13hihi31/tt09-analog-tdc/mag/input_stage_andpwr.sim.spice

* NGSPICE file created from input_stage_andpwr_parax.ext - technology: sky130A

.subckt input_stage_andpwr_parax in en t0 t1 t2 t3 and_pwr VDD VSS out
X0 a_2134_616# t0.t0 a_1870_1170# VSS.t10 sky130_fd_pr__nfet_01v8 ad=0.29 pd=2.29 as=0.58 ps=4.58 w=2 l=0.15
X1 a_3160_1170# fine_delay_unit_1.in VDD.t7 VDD.t6 sky130_fd_pr__pfet_01v8 ad=0.87 pd=6.58 as=0.87 ps=6.58 w=3 l=0.15
X2 a_3248_1170# fine_delay_unit_1.in a_3160_1170# VSS.t20 sky130_fd_pr__nfet_01v8 ad=0.145 pd=1.29 as=0.145 ps=1.29 w=1 l=0.15
X3 VSS.t13 t3.t0 a_3512_616# VSS.t12 sky130_fd_pr__nfet_01v8 ad=0.58 pd=4.58 as=0.29 ps=2.29 w=2 l=0.15
X4 VSS.t11 fine_delay_unit_0.in a_2134_616# VSS.t0 sky130_fd_pr__nfet_01v8 ad=0.145 pd=1.29 as=0.145 ps=1.29 w=1 l=0.15
X5 nand_gate_0.out in.t0 and_pwr.t3 and_pwr.t2 sky130_fd_pr__pfet_01v8 ad=0.435 pd=3.29 as=0.87 ps=6.58 w=3 l=0.15
X6 VSS.t19 fine_delay_unit_1.in a_3512_616# VSS.t12 sky130_fd_pr__nfet_01v8 ad=0.145 pd=1.29 as=0.145 ps=1.29 w=1 l=0.15
X7 a_306_476# in.t1 VSS.t22 VSS.t21 sky130_fd_pr__nfet_01v8 ad=0.29 pd=2.29 as=0.58 ps=4.58 w=2 l=0.15
X8 fine_delay_unit_0.in nand_gate_0.out and_pwr.t1 and_pwr.t0 sky130_fd_pr__pfet_01v8 ad=0.87 pd=6.58 as=0.87 ps=6.58 w=3 l=0.15
X9 a_3160_1170# fine_delay_unit_1.in a_3248_1170# VSS.t18 sky130_fd_pr__nfet_01v8 ad=0.145 pd=1.29 as=0.145 ps=1.29 w=1 l=0.15
X10 a_2134_616# fine_delay_unit_0.in a_1870_1170# VSS.t10 sky130_fd_pr__nfet_01v8 ad=0.145 pd=1.29 as=0.145 ps=1.29 w=1 l=0.15
X11 VSS.t1 t1.t0 a_2134_616# VSS.t0 sky130_fd_pr__nfet_01v8 ad=0.58 pd=4.58 as=0.29 ps=2.29 w=2 l=0.15
X12 out.t0 a_3160_1170# VSS.t16 VSS.t15 sky130_fd_pr__nfet_01v8 ad=0.29 pd=2.58 as=0.145 ps=1.29 w=1 l=0.15
X13 a_3512_616# t2.t0 a_3248_1170# VSS.t2 sky130_fd_pr__nfet_01v8 ad=0.29 pd=2.29 as=0.58 ps=4.58 w=2 l=0.15
X14 a_1870_1170# fine_delay_unit_0.in a_1782_1170# VSS.t9 sky130_fd_pr__nfet_01v8 ad=0.145 pd=1.29 as=0.29 ps=2.58 w=1 l=0.15
X15 fine_delay_unit_0.in nand_gate_0.out VSS.t6 VSS.t5 sky130_fd_pr__nfet_01v8 ad=0.29 pd=2.58 as=0.29 ps=2.58 w=1 l=0.15
X16 a_3512_616# fine_delay_unit_1.in a_3248_1170# VSS.t2 sky130_fd_pr__nfet_01v8 ad=0.145 pd=1.29 as=0.145 ps=1.29 w=1 l=0.15
X17 out.t1 a_3160_1170# VDD.t5 VDD.t4 sky130_fd_pr__pfet_01v8 ad=0.87 pd=6.58 as=0.87 ps=6.58 w=3 l=0.15
X18 a_3248_1170# fine_delay_unit_1.in a_3160_1170# VSS.t17 sky130_fd_pr__nfet_01v8 ad=0.145 pd=1.29 as=0.29 ps=2.58 w=1 l=0.15
X19 a_1782_1170# fine_delay_unit_0.in VDD.t3 VDD.t2 sky130_fd_pr__pfet_01v8 ad=0.87 pd=6.58 as=0.87 ps=6.58 w=3 l=0.15
X20 fine_delay_unit_1.in a_1782_1170# VSS.t4 VSS.t3 sky130_fd_pr__nfet_01v8 ad=0.29 pd=2.58 as=0.145 ps=1.29 w=1 l=0.15
X21 and_pwr.t5 en.t0 nand_gate_0.out and_pwr.t4 sky130_fd_pr__pfet_01v8 ad=0.87 pd=6.58 as=0.435 ps=3.29 w=3 l=0.15
X22 a_1870_1170# fine_delay_unit_0.in a_1782_1170# VSS.t8 sky130_fd_pr__nfet_01v8 ad=0.145 pd=1.29 as=0.145 ps=1.29 w=1 l=0.15
X23 nand_gate_0.out en.t1 a_306_476# VSS.t14 sky130_fd_pr__nfet_01v8 ad=0.58 pd=4.58 as=0.29 ps=2.29 w=2 l=0.15
X24 a_1782_1170# fine_delay_unit_0.in a_1870_1170# VSS.t7 sky130_fd_pr__nfet_01v8 ad=0.145 pd=1.29 as=0.145 ps=1.29 w=1 l=0.15
X25 fine_delay_unit_1.in a_1782_1170# VDD.t1 VDD.t0 sky130_fd_pr__pfet_01v8 ad=0.87 pd=6.58 as=0.87 ps=6.58 w=3 l=0.15
R0 t0 t0.t0 577.703
R1 VSS.n32 VSS.n9 13220.9
R2 VSS.n61 VSS.n33 4447.27
R3 VSS.n48 VSS.n35 4447.27
R4 VSS.n64 VSS.n61 3442.57
R5 VSS.n56 VSS.n35 3442.57
R6 VSS.n33 VSS.n6 3165.68
R7 VSS.n48 VSS.n40 3165.68
R8 VSS.n58 VSS.n57 2206.9
R9 VSS.n64 VSS.n8 2206.4
R10 VSS.n56 VSS.n36 2206.4
R11 VSS.n21 VSS.n18 1707.33
R12 VSS.n21 VSS.n17 1707.33
R13 VSS.n31 VSS.t5 1497.65
R14 VSS.n11 VSS.t5 1497.65
R15 VSS.n68 VSS.n8 1438.1
R16 VSS.n52 VSS.n36 1438.1
R17 VSS.n11 VSS.n9 1366.29
R18 VSS.n19 VSS.n9 1178.35
R19 VSS.n32 VSS.n31 1157.75
R20 VSS.n68 VSS.n6 1065.44
R21 VSS.n52 VSS.n40 1065.44
R22 VSS.n12 VSS.n10 1058.19
R23 VSS.n30 VSS.n10 1058.19
R24 VSS.n65 VSS.n32 1020.69
R25 VSS.t21 VSS.n18 1000.06
R26 VSS.t14 VSS.n19 902.564
R27 VSS.t15 VSS.n48 559.691
R28 VSS.t3 VSS.n58 520.691
R29 VSS.n57 VSS.n34 403.449
R30 VSS.n66 VSS.n65 403.449
R31 VSS.t12 VSS.t15 303.449
R32 VSS.t2 VSS.t12 303.449
R33 VSS.t18 VSS.t20 303.449
R34 VSS.t0 VSS.t3 303.449
R35 VSS.t10 VSS.t0 303.449
R36 VSS.t8 VSS.t7 303.449
R37 VSS.n54 VSS.n36 292.5
R38 VSS.n36 VSS.n34 292.5
R39 VSS.n8 VSS.n7 292.5
R40 VSS.n66 VSS.n8 292.5
R41 VSS.n62 VSS.n5 288.961
R42 VSS.n47 VSS.n37 288.961
R43 VSS.n51 VSS.t17 286.207
R44 VSS.n67 VSS.t9 286.207
R45 VSS.n20 VSS.t14 275.784
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
R197 VDD.n8 VDD.n5 0.115083
R198 VDD.n20 VDD.n1 0.115083
R199 VDD.n19 VDD.n18 0.0899097
R200 VDD.n32 VDD.n31 0.0899097
R201 VDD.n17 VDD.n5 0.0647361
R202 VDD.n30 VDD.n1 0.0647361
R203 t3 t3.t0 727.149
R204 in.n0 in.t0 618.668
R205 in.n0 in.t1 456.997
R206 in in.n0 161.375
R207 and_pwr.n13 and_pwr.n12 1348.04
R208 and_pwr.n15 and_pwr.n12 1348.04
R209 and_pwr.n4 and_pwr.n2 1307.92
R210 and_pwr.n4 and_pwr.t0 181.478
R211 and_pwr.t4 and_pwr.n13 181.043
R212 and_pwr.n15 and_pwr.t2 176.736
R213 and_pwr.n3 and_pwr.n0 175.123
R214 and_pwr.n17 and_pwr.n16 143.792
R215 and_pwr.n17 and_pwr.n10 143.792
R216 and_pwr.n6 and_pwr.n0 139.512
R217 and_pwr.n6 and_pwr.n5 139.512
R218 and_pwr.n1 and_pwr.t1 84.7934
R219 and_pwr.n11 and_pwr.t3 84.7879
R220 and_pwr.n19 and_pwr.t5 84.7879
R221 and_pwr.t2 and_pwr.n14 49.547
R222 and_pwr.n6 and_pwr.n2 46.2505
R223 and_pwr.n14 and_pwr.t4 45.2386
R224 and_pwr.n3 and_pwr.n2 39.3924
R225 and_pwr.n16 and_pwr.n15 20.5561
R226 and_pwr.n13 and_pwr.n10 20.5561
R227 and_pwr.n5 and_pwr.n4 20.5561
R228 and_pwr.n17 and_pwr.n12 18.5005
R229 and_pwr.n14 and_pwr.n12 18.5005
R230 and_pwr.t0 and_pwr.n3 5.4667
R231 and_pwr.n7 and_pwr.n6 2.3255
R232 and_pwr.n8 and_pwr.n0 2.2281
R233 and_pwr.n5 and_pwr.n1 2.17472
R234 and_pwr.n16 and_pwr.n11 2.16438
R235 and_pwr.n20 and_pwr.n10 2.0406
R236 and_pwr.n18 and_pwr.n17 1.8605
R237 and_pwr and_pwr.n9 0.620598
R238 and_pwr.n9 and_pwr.n8 0.223
R239 and_pwr.n20 and_pwr.n19 0.129176
R240 and_pwr.n18 and_pwr.n11 0.110794
R241 and_pwr.n19 and_pwr.n18 0.105892
R242 and_pwr.n7 and_pwr.n1 0.0577917
R243 and_pwr and_pwr.n20 0.0103039
R244 and_pwr.n9 and_pwr 0.00540196
R245 and_pwr.n8 and_pwr.n7 0.00440625
R246 t1 t1.t0 727.149
R247 out out.t1 84.8477
R248 out out.t0 84.7009
R249 t2 t2.t0 577.703
R250 en.n0 en.t0 564.04
R251 en.n0 en.t1 511.623
R252 en en.n0 161.333
C0 t1 and_pwr 2.95e-19
C1 a_1870_1170# fine_delay_unit_1.in 7.4e-19
C2 a_2134_616# nand_gate_0.out 4.47e-20
C3 t3 a_3248_1170# 0.001628f
C4 a_2134_616# fine_delay_unit_0.in 0.028846f
C5 t1 VDD 0.002869f
C6 and_pwr in 0.118135f
C7 a_306_476# in 0.009499f
C8 a_1870_1170# t0 0.022005f
C9 a_2134_616# t2 6.6e-22
C10 a_2134_616# a_1782_1170# 0.019821f
C11 VDD a_3160_1170# 1.25072f
C12 a_2134_616# fine_delay_unit_1.in 5.97e-19
C13 t3 out 0.034216f
C14 a_2134_616# t0 0.02185f
C15 t3 a_3512_616# 0.013742f
C16 t3 t2 0.014805f
C17 fine_delay_unit_0.in a_3248_1170# 1.39e-20
C18 nand_gate_0.out en 0.12418f
C19 fine_delay_unit_0.in en 0.001628f
C20 out a_3248_1170# 3.44e-20
C21 a_3512_616# a_3248_1170# 0.556904f
C22 t2 a_3248_1170# 0.022005f
C23 a_1782_1170# a_3248_1170# 2.1e-21
C24 t3 fine_delay_unit_1.in 0.020481f
C25 a_1870_1170# t1 0.001628f
C26 fine_delay_unit_1.in a_3248_1170# 0.244525f
C27 nand_gate_0.out fine_delay_unit_0.in 0.062526f
C28 nand_gate_0.out a_1782_1170# 3.78e-19
C29 fine_delay_unit_0.in a_1782_1170# 0.253714f
C30 out a_3512_616# 7.3e-20
C31 a_3512_616# t2 0.02185f
C32 a_1782_1170# a_3512_616# 7.57e-22
C33 a_2134_616# t1 0.013742f
C34 fine_delay_unit_0.in fine_delay_unit_1.in 0.030121f
C35 t3 VDD 0.004852f
C36 and_pwr en 0.149958f
C37 a_306_476# en 0.009499f
C38 fine_delay_unit_1.in out 0.00207f
C39 fine_delay_unit_1.in a_3512_616# 0.028846f
C40 fine_delay_unit_1.in t2 0.009158f
C41 fine_delay_unit_1.in a_1782_1170# 0.130035f
C42 nand_gate_0.out t0 9.64e-20
C43 fine_delay_unit_0.in t0 0.009343f
C44 en VDD 8.02e-20
C45 t2 t0 0.003859f
C46 a_1782_1170# t0 0.003337f
C47 t3 t1 0.001296f
C48 and_pwr nand_gate_0.out 1.2824f
C49 a_306_476# nand_gate_0.out 0.355469f
C50 a_1870_1170# a_2134_616# 0.556904f
C51 and_pwr fine_delay_unit_0.in 1.23478f
C52 t1 a_3248_1170# 1.01e-19
C53 t3 a_3160_1170# 0.010812f
C54 nand_gate_0.out VDD 4.83e-20
C55 and_pwr a_1782_1170# 0.002135f
C56 fine_delay_unit_0.in VDD 0.307528f
C57 a_3160_1170# a_3248_1170# 0.53267f
C58 VDD out 0.963042f
C59 en in 0.078266f
C60 VDD t2 4.29e-19
C61 VDD a_1782_1170# 1.25227f
C62 t1 nand_gate_0.out 2.7e-20
C63 VDD fine_delay_unit_1.in 1.33558f
C64 t1 fine_delay_unit_0.in 0.020557f
C65 and_pwr t0 1.96e-19
C66 a_1870_1170# en 5.43e-20
C67 t1 a_3512_616# 2.21e-20
C68 t1 t2 5.63e-19
C69 t1 a_1782_1170# 0.010812f
C70 nand_gate_0.out in 0.050326f
C71 fine_delay_unit_0.in in 5.53e-19
C72 VDD t0 4.29e-19
C73 and_pwr a_306_476# 7.57e-19
C74 t1 fine_delay_unit_1.in 0.039118f
C75 out a_3160_1170# 0.115353f
C76 a_3512_616# a_3160_1170# 0.019821f
C77 a_3160_1170# t2 0.003337f
C78 a_1782_1170# a_3160_1170# 0.001737f
C79 a_1870_1170# nand_gate_0.out 5.26e-20
C80 and_pwr VDD 0.0313f
C81 a_1870_1170# fine_delay_unit_0.in 0.244525f
C82 fine_delay_unit_1.in a_3160_1170# 0.253736f
C83 t1 t0 0.014805f
C84 a_1870_1170# a_1782_1170# 0.53267f
C85 t2 VSS 0.309129f
C86 t3 VSS 0.375997f
C87 t0 VSS 0.309038f
C88 t1 VSS 0.371058f
C89 out VSS 0.493979f
C90 en VSS 0.179937f
C91 in VSS 0.247895f
C92 VDD VSS 7.77543f
C93 and_pwr VSS 3.7652f
C94 a_3512_616# VSS 0.612975f
C95 a_3248_1170# VSS 0.387205f
C96 a_2134_616# VSS 0.612975f
C97 a_1870_1170# VSS 0.387205f
C98 a_306_476# VSS 0.371906f
C99 a_3160_1170# VSS 0.739963f
C100 fine_delay_unit_1.in VSS 1.71608f
C101 nand_gate_0.out VSS 0.89651f
C102 a_1782_1170# VSS 0.7316f
C103 fine_delay_unit_0.in VSS 1.83203f
.ends
