13hihi31/tt09-analog-tdc/mag/variable_delay_dummy.sim.spice

* NGSPICE file created from variable_delay_dummy_parax.ext - technology: sky130A

.subckt variable_delay_dummy_parax in out VSS VDD
X0 VDD.t36 VDD.t34 a_5444_772# VDD.t35 sky130_fd_pr__pfet_01v8 ad=0.87 pd=6.58 as=0.435 ps=3.29 w=3 l=0.15
X1 VDD.t33 VDD.t31 a_2496_772# VDD.t32 sky130_fd_pr__pfet_01v8 ad=0.87 pd=6.58 as=0.435 ps=3.29 w=3 l=0.15
X2 VDD.t30 VDD.t28 a_5444_772# VDD.t29 sky130_fd_pr__pfet_01v8 ad=0.435 pd=3.29 as=0.435 ps=3.29 w=3 l=0.15
X3 VSS.t33 variable_delay_unit_1.tristate_inverter_1.en.t2 a_5444_352# VSS.t32 sky130_fd_pr__nfet_01v8 ad=0.29 pd=2.58 as=0.145 ps=1.29 w=1 l=0.15
X4 variable_delay_unit_1.out variable_delay_unit_1.forward.t2 a_4562_772# VDD.t39 sky130_fd_pr__pfet_01v8 ad=0.87 pd=6.58 as=0.435 ps=3.29 w=3 l=0.15
X5 VSS.t35 variable_delay_unit_0.tristate_inverter_1.en.t2 a_2496_352# VSS.t34 sky130_fd_pr__nfet_01v8 ad=0.29 pd=2.58 as=0.145 ps=1.29 w=1 l=0.15
X6 VSS.t31 variable_delay_unit_1.tristate_inverter_1.en.t3 a_5444_352# VSS.t30 sky130_fd_pr__nfet_01v8 ad=0.145 pd=1.29 as=0.145 ps=1.29 w=1 l=0.15
X7 variable_delay_unit_0.tristate_inverter_1.en.t1 VDD.t25 VDD.t27 VDD.t26 sky130_fd_pr__pfet_01v8 ad=0.87 pd=6.58 as=0.87 ps=6.58 w=3 l=0.15
X8 VDD.t43 variable_delay_unit_1.tristate_inverter_1.en.t4 a_4562_772# VDD.t42 sky130_fd_pr__pfet_01v8 ad=0.435 pd=3.29 as=0.435 ps=3.29 w=3 l=0.15
X9 out.t3 variable_delay_unit_1.in.t2 a_1614_772# VDD.t3 sky130_fd_pr__pfet_01v8 ad=0.87 pd=6.58 as=0.435 ps=3.29 w=3 l=0.15
X10 VSS.t24 VDD.t44 a_4562_352# VSS.t23 sky130_fd_pr__nfet_01v8 ad=0.145 pd=1.29 as=0.145 ps=1.29 w=1 l=0.15
X11 variable_delay_unit_1.out variable_delay_unit_1.forward.t3 a_4562_352# VSS.t27 sky130_fd_pr__nfet_01v8 ad=0.29 pd=2.58 as=0.145 ps=1.29 w=1 l=0.15
X12 variable_delay_unit_0.tristate_inverter_1.en.t0 VDD.t45 VSS.t20 VSS.t19 sky130_fd_pr__nfet_01v8 ad=0.29 pd=2.58 as=0.29 ps=2.58 w=1 l=0.15
X13 out.t2 variable_delay_unit_1.in.t3 a_1614_352# VSS.t36 sky130_fd_pr__nfet_01v8 ad=0.29 pd=2.58 as=0.145 ps=1.29 w=1 l=0.15
X14 a_2496_772# variable_delay_unit_1.out out.t0 VDD.t8 sky130_fd_pr__pfet_01v8 ad=0.435 pd=3.29 as=0.87 ps=6.58 w=3 l=0.15
X15 a_2496_352# variable_delay_unit_1.out out.t1 VSS.t8 sky130_fd_pr__nfet_01v8 ad=0.145 pd=1.29 as=0.29 ps=2.58 w=1 l=0.15
X16 a_1614_772# variable_delay_unit_0.tristate_inverter_1.en.t3 VDD.t2 VDD.t1 sky130_fd_pr__pfet_01v8 ad=0.435 pd=3.29 as=0.87 ps=6.58 w=3 l=0.15
X17 a_5444_772# VDD.t22 VDD.t24 VDD.t23 sky130_fd_pr__pfet_01v8 ad=0.435 pd=3.29 as=0.435 ps=3.29 w=3 l=0.15
X18 a_1614_352# VDD.t46 VSS.t22 VSS.t21 sky130_fd_pr__nfet_01v8 ad=0.145 pd=1.29 as=0.29 ps=2.58 w=1 l=0.15
X19 variable_delay_unit_1.tristate_inverter_1.en.t1 VDD.t19 VDD.t21 VDD.t20 sky130_fd_pr__pfet_01v8 ad=0.87 pd=6.58 as=0.87 ps=6.58 w=3 l=0.15
X20 a_5444_772# VSS.t37 variable_delay_unit_1.out VDD.t0 sky130_fd_pr__pfet_01v8 ad=0.435 pd=3.29 as=0.87 ps=6.58 w=3 l=0.15
X21 variable_delay_unit_1.tristate_inverter_1.en.t0 VDD.t47 VSS.t18 VSS.t17 sky130_fd_pr__nfet_01v8 ad=0.29 pd=2.58 as=0.29 ps=2.58 w=1 l=0.15
X22 a_5444_352# variable_delay_unit_1.tristate_inverter_1.en.t5 VSS.t29 VSS.t28 sky130_fd_pr__nfet_01v8 ad=0.145 pd=1.29 as=0.145 ps=1.29 w=1 l=0.15
X23 a_2496_772# VDD.t16 VDD.t18 VDD.t17 sky130_fd_pr__pfet_01v8 ad=0.435 pd=3.29 as=0.435 ps=3.29 w=3 l=0.15
X24 a_2496_352# variable_delay_unit_0.tristate_inverter_1.en.t4 VSS.t1 VSS.t0 sky130_fd_pr__nfet_01v8 ad=0.145 pd=1.29 as=0.145 ps=1.29 w=1 l=0.15
X25 a_5444_352# VSS.t2 variable_delay_unit_1.out VSS.t3 sky130_fd_pr__nfet_01v8 ad=0.145 pd=1.29 as=0.29 ps=2.58 w=1 l=0.15
X26 a_1614_772# variable_delay_unit_0.tristate_inverter_1.en.t5 VDD.t12 VDD.t11 sky130_fd_pr__pfet_01v8 ad=0.435 pd=3.29 as=0.435 ps=3.29 w=3 l=0.15
X27 a_4562_772# variable_delay_unit_1.tristate_inverter_1.en.t6 VDD.t10 VDD.t9 sky130_fd_pr__pfet_01v8 ad=0.435 pd=3.29 as=0.87 ps=6.58 w=3 l=0.15
X28 a_1614_352# VDD.t48 VSS.t16 VSS.t15 sky130_fd_pr__nfet_01v8 ad=0.145 pd=1.29 as=0.145 ps=1.29 w=1 l=0.15
X29 a_4562_352# VDD.t49 VSS.t14 VSS.t13 sky130_fd_pr__nfet_01v8 ad=0.145 pd=1.29 as=0.29 ps=2.58 w=1 l=0.15
X30 variable_delay_unit_1.in.t0 in.t0 VDD.t5 VDD.t4 sky130_fd_pr__pfet_01v8 ad=0.87 pd=6.58 as=0.87 ps=6.58 w=3 l=0.15
X31 variable_delay_unit_1.in.t1 in.t1 VSS.t5 VSS.t4 sky130_fd_pr__nfet_01v8 ad=0.29 pd=2.58 as=0.29 ps=2.58 w=1 l=0.15
X32 a_4562_772# variable_delay_unit_1.tristate_inverter_1.en.t7 VDD.t41 VDD.t40 sky130_fd_pr__pfet_01v8 ad=0.435 pd=3.29 as=0.435 ps=3.29 w=3 l=0.15
X33 a_4562_352# VDD.t50 VSS.t12 VSS.t11 sky130_fd_pr__nfet_01v8 ad=0.145 pd=1.29 as=0.145 ps=1.29 w=1 l=0.15
X34 VDD.t15 VDD.t13 a_2496_772# VDD.t14 sky130_fd_pr__pfet_01v8 ad=0.435 pd=3.29 as=0.435 ps=3.29 w=3 l=0.15
X35 variable_delay_unit_1.forward.t1 variable_delay_unit_1.in.t4 VDD.t38 VDD.t37 sky130_fd_pr__pfet_01v8 ad=0.87 pd=6.58 as=0.87 ps=6.58 w=3 l=0.15
X36 VSS.t7 variable_delay_unit_0.tristate_inverter_1.en.t6 a_2496_352# VSS.t6 sky130_fd_pr__nfet_01v8 ad=0.145 pd=1.29 as=0.145 ps=1.29 w=1 l=0.15
X37 variable_delay_unit_1.forward.t0 variable_delay_unit_1.in.t5 VSS.t26 VSS.t25 sky130_fd_pr__nfet_01v8 ad=0.29 pd=2.58 as=0.29 ps=2.58 w=1 l=0.15
X38 VDD.t7 variable_delay_unit_0.tristate_inverter_1.en.t7 a_1614_772# VDD.t6 sky130_fd_pr__pfet_01v8 ad=0.435 pd=3.29 as=0.435 ps=3.29 w=3 l=0.15
X39 VSS.t10 VDD.t51 a_1614_352# VSS.t9 sky130_fd_pr__nfet_01v8 ad=0.145 pd=1.29 as=0.145 ps=1.29 w=1 l=0.15
R0 VDD.n106 VDD.n64 1689.71
R1 VDD.n69 VDD.n64 1689.71
R2 VDD.n62 VDD.n61 1689.71
R3 VDD.n109 VDD.n61 1689.71
R4 VDD.n30 VDD.n13 1689.71
R5 VDD.n30 VDD.n14 1689.71
R6 VDD.n20 VDD.n15 1689.71
R7 VDD.n26 VDD.n15 1689.71
R8 VDD.n44 VDD.n3 1307.92
R9 VDD.n40 VDD.n4 1307.92
R10 VDD.n89 VDD.n77 1307.92
R11 VDD.n74 VDD.n73 1307.92
R12 VDD.n79 VDD.t31 628.097
R13 VDD.n50 VDD.t34 628.097
R14 VDD.n80 VDD.t13 622.766
R15 VDD.n51 VDD.t28 622.766
R16 VDD.n83 VDD.t25 543.053
R17 VDD.n54 VDD.t19 543.053
R18 VDD.n79 VDD.t16 523.774
R19 VDD.n50 VDD.t22 523.774
R20 VDD.n108 VDD.n107 332.803
R21 VDD.n28 VDD.n27 332.803
R22 VDD.n78 VDD.t46 304.647
R23 VDD.n78 VDD.t48 304.647
R24 VDD.n49 VDD.t49 304.647
R25 VDD.n49 VDD.t50 304.647
R26 VDD.n83 VDD.t45 221.72
R27 VDD.n54 VDD.t47 221.72
R28 VDD.n84 VDD.n83 219.549
R29 VDD.n55 VDD.n54 219.531
R30 VDD.n78 VDD.t51 202.44
R31 VDD.n49 VDD.t44 202.44
R32 VDD.n105 VDD.n65 180.236
R33 VDD.n70 VDD.n65 180.236
R34 VDD.n111 VDD.n110 180.236
R35 VDD.n111 VDD.n57 180.236
R36 VDD.n31 VDD.n12 180.236
R37 VDD.n31 VDD.n8 180.236
R38 VDD.n25 VDD.n16 180.236
R39 VDD.n21 VDD.n16 180.236
R40 VDD.n43 VDD.n0 175.123
R41 VDD.n7 VDD.n6 175.123
R42 VDD.n92 VDD.n91 175.123
R43 VDD.n87 VDD.n71 175.123
R44 VDD VDD.n78 168.969
R45 VDD VDD.n49 168.969
R46 VDD VDD.n80 166.147
R47 VDD VDD.n51 166.147
R48 VDD.t32 VDD.n62 163.724
R49 VDD.n69 VDD.t1 163.724
R50 VDD.n20 VDD.t35 163.724
R51 VDD.t9 VDD.n14 163.724
R52 VDD.n41 VDD.t37 160.923
R53 VDD.t20 VDD.n42 160.923
R54 VDD.n88 VDD.t4 160.923
R55 VDD.t26 VDD.n90 160.923
R56 VDD.n108 VDD.t8 145.224
R57 VDD.n107 VDD.t3 145.224
R58 VDD.n27 VDD.t0 145.224
R59 VDD.t39 VDD.n28 145.224
R60 VDD.n45 VDD.n2 139.512
R61 VDD.n45 VDD.n0 139.512
R62 VDD.n39 VDD.n5 139.512
R63 VDD.n7 VDD.n5 139.512
R64 VDD.n93 VDD.n75 139.512
R65 VDD.n93 VDD.n92 139.512
R66 VDD.n98 VDD.n97 139.512
R67 VDD.n98 VDD.n71 139.512
R68 VDD.n42 VDD.n41 119.861
R69 VDD.n90 VDD.n88 119.861
R70 VDD.t17 VDD.t32 88.7478
R71 VDD.t8 VDD.t14 88.7478
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
R469 variable_delay_unit_0.tristate_inverter_1.en.n0 variable_delay_unit_0.tristate_inverter_1.en.t6 304.647
R470 variable_delay_unit_0.tristate_inverter_1.en.n0 variable_delay_unit_0.tristate_inverter_1.en.t2 304.647
R471 variable_delay_unit_0.tristate_inverter_1.en.n0 variable_delay_unit_0.tristate_inverter_1.en.t4 202.44
R472 variable_delay_unit_0.tristate_inverter_1.en variable_delay_unit_0.tristate_inverter_1.en.n0 168.969
R473 variable_delay_unit_0.tristate_inverter_1.en variable_delay_unit_0.tristate_inverter_1.en.n4 166.147
R474 variable_delay_unit_0.tristate_inverter_1.en.n1 variable_delay_unit_0.tristate_inverter_1.en.t1 84.7557
R475 variable_delay_unit_0.tristate_inverter_1.en.n1 variable_delay_unit_0.tristate_inverter_1.en.t0 84.1197
R476 variable_delay_unit_0.tristate_inverter_1.en.n2 variable_delay_unit_0.tristate_inverter_1.en.n1 12.6535
R477 variable_delay_unit_0.tristate_inverter_1.en.n2 variable_delay_unit_0.tristate_inverter_1.en 5.58443
R478 variable_delay_unit_0.tristate_inverter_1.en variable_delay_unit_0.tristate_inverter_1.en.n2 4.59003
R479 variable_delay_unit_0.tristate_inverter_1.en.n4 variable_delay_unit_0.tristate_inverter_1.en.n3 1.09595
R480 variable_delay_unit_1.in.n0 variable_delay_unit_1.in.t2 607.409
R481 variable_delay_unit_1.in.n2 variable_delay_unit_1.in.t4 543.053
R482 variable_delay_unit_1.in.n0 variable_delay_unit_1.in.t3 321.423
R483 variable_delay_unit_1.in variable_delay_unit_1.in.n2 221.778
R484 variable_delay_unit_1.in.n2 variable_delay_unit_1.in.t5 221.72
R485 variable_delay_unit_1.in variable_delay_unit_1.in.n0 161.72
R486 variable_delay_unit_1.in.n1 variable_delay_unit_1.in.t0 84.7227
R487 variable_delay_unit_1.in.n1 variable_delay_unit_1.in.t1 84.0867
R488 variable_delay_unit_1.in.n3 variable_delay_unit_1.in 20.0791
R489 variable_delay_unit_1.in variable_delay_unit_1.in.n3 0.851271
R490 variable_delay_unit_1.in.n3 variable_delay_unit_1.in.n1 0.465495
R491 out.n0 out.t0 84.8477
R492 out.n2 out.t3 84.8477
R493 out.n0 out.t1 84.2063
R494 out.n2 out.t2 84.1683
R495 out out.n3 10.0241
R496 out.n1 out 0.681535
R497 out out.n0 0.287138
R498 out.n3 out 0.0803611
R499 out.n3 out.n2 0.0508472
R500 out.n1 out 0.013431
R501 out out.n1 0.0109167
R502 in.n0 in.t0 543.053
R503 in.n0 in.t1 221.72
R504 in in.n0 221.565
C0 VDD a_4562_352# 0.160518f
C1 variable_delay_unit_0.tristate_inverter_1.en a_1614_772# 0.11539f
C2 variable_delay_unit_1.tristate_inverter_1.en VDD 3.86972f
C3 VDD variable_delay_unit_1.out 1.61031f
C4 a_2496_352# a_2496_772# 0.011184f
C5 variable_delay_unit_1.tristate_inverter_1.en out 0.002141f
C6 out variable_delay_unit_1.out 0.071795f
C7 variable_delay_unit_1.forward a_4562_772# 0.088132f
C8 in variable_delay_unit_1.in 0.08442f
C9 variable_delay_unit_1.tristate_inverter_1.en a_5444_772# 0.029284f
C10 a_5444_772# variable_delay_unit_1.out 0.493816f
C11 variable_delay_unit_0.tristate_inverter_1.en a_2496_352# 0.15982f
C12 a_4562_352# variable_delay_unit_1.forward 0.054206f
C13 variable_delay_unit_1.out a_2496_772# 0.071074f
C14 variable_delay_unit_1.in a_1614_772# 0.088132f
C15 variable_delay_unit_1.tristate_inverter_1.en variable_delay_unit_1.forward 0.794183f
C16 variable_delay_unit_1.forward variable_delay_unit_1.out 0.234428f
C17 VDD out 1.37861f
C18 in a_1614_772# 8.82e-20
C19 variable_delay_unit_1.in a_5444_352# 7.65e-21
C20 VDD a_5444_772# 1.78268f
C21 VDD a_1614_352# 0.160518f
C22 variable_delay_unit_1.tristate_inverter_1.en variable_delay_unit_0.tristate_inverter_1.en 0.002365f
C23 variable_delay_unit_0.tristate_inverter_1.en variable_delay_unit_1.out 0.085059f
C24 VDD a_2496_772# 1.78275f
C25 out a_1614_352# 0.222585f
C26 VDD variable_delay_unit_1.forward 2.28565f
C27 out a_2496_772# 0.493816f
C28 a_4562_772# variable_delay_unit_1.in 8.82e-20
C29 in a_2496_352# 7.65e-21
C30 VDD variable_delay_unit_0.tristate_inverter_1.en 3.86872f
C31 a_4562_352# variable_delay_unit_1.in 8.82e-20
C32 a_5444_772# variable_delay_unit_1.forward 0.016896f
C33 variable_delay_unit_1.tristate_inverter_1.en variable_delay_unit_1.in 0.09141f
C34 variable_delay_unit_0.tristate_inverter_1.en out 0.12022f
C35 variable_delay_unit_1.in variable_delay_unit_1.out 0.499092f
C36 variable_delay_unit_0.tristate_inverter_1.en a_1614_352# 2.39e-19
C37 variable_delay_unit_0.tristate_inverter_1.en a_2496_772# 0.029284f
C38 variable_delay_unit_0.tristate_inverter_1.en variable_delay_unit_1.forward 7.91e-21
C39 VDD variable_delay_unit_1.in 3.20907f
C40 variable_delay_unit_1.tristate_inverter_1.en a_5444_352# 0.15982f
C41 variable_delay_unit_1.out a_5444_352# 0.172055f
C42 VDD in 0.498166f
C43 out variable_delay_unit_1.in 0.235655f
C44 out in 0.487038f
C45 VDD a_1614_772# 1.70112f
C46 a_5444_772# variable_delay_unit_1.in 7.65e-21
C47 a_1614_352# variable_delay_unit_1.in 0.054206f
C48 a_4562_352# a_4562_772# 0.004142f
C49 a_2496_352# variable_delay_unit_1.out 0.070146f
C50 VDD a_5444_352# 0.003377f
C51 in a_1614_352# 8.82e-20
C52 variable_delay_unit_1.in a_2496_772# 0.020173f
C53 variable_delay_unit_1.tristate_inverter_1.en a_4562_772# 0.11539f
C54 out a_1614_772# 0.505512f
C55 a_4562_772# variable_delay_unit_1.out 0.505512f
C56 variable_delay_unit_1.forward variable_delay_unit_1.in 0.087283f
C57 in a_2496_772# 7.65e-21
C58 variable_delay_unit_1.tristate_inverter_1.en a_4562_352# 2.39e-19
C59 a_4562_352# variable_delay_unit_1.out 0.222585f
C60 a_1614_352# a_1614_772# 0.004142f
C61 variable_delay_unit_1.tristate_inverter_1.en variable_delay_unit_1.out 0.12029f
C62 variable_delay_unit_0.tristate_inverter_1.en variable_delay_unit_1.in 0.814958f
C63 VDD a_2496_352# 0.003447f
C64 a_5444_772# a_5444_352# 0.011184f
C65 variable_delay_unit_0.tristate_inverter_1.en in 0.091118f
C66 VDD a_4562_772# 1.70112f
C67 out a_2496_352# 0.172055f
C68 out VSS 1.89289f
C69 in VSS 1.0591f
C70 VDD VSS 21.536554f
C71 a_5444_352# VSS 0.784074f
C72 a_4562_352# VSS 0.71648f
C73 a_2496_352# VSS 0.717347f
C74 a_1614_352# VSS 0.71648f
C75 a_5444_772# VSS 0.114203f
C76 a_4562_772# VSS 0.037888f
C77 variable_delay_unit_1.forward VSS 2.632682f
C78 variable_delay_unit_1.tristate_inverter_1.en VSS 2.962361f
C79 a_2496_772# VSS 0.043128f
C80 variable_delay_unit_1.out VSS 2.29732f
C81 a_1614_772# VSS 0.037888f
C82 variable_delay_unit_1.in VSS 4.167534f
C83 variable_delay_unit_0.tristate_inverter_1.en VSS 2.857091f
C84 variable_delay_unit_1.in.t2 VSS 0.068546f
C85 variable_delay_unit_1.in.t3 VSS 0.025993f
C86 variable_delay_unit_1.in.n0 VSS 0.072091f
C87 variable_delay_unit_1.in.t1 VSS 0.050497f
C88 variable_delay_unit_1.in.t0 VSS 0.160539f
C89 variable_delay_unit_1.in.n1 VSS 0.389091f
C90 variable_delay_unit_1.in.t4 VSS 0.065437f
C91 variable_delay_unit_1.in.t5 VSS 0.021123f
C92 variable_delay_unit_1.in.n2 VSS 0.068813f
C93 variable_delay_unit_1.in.n3 VSS 0.640809f
C94 variable_delay_unit_0.tristate_inverter_1.en.t4 VSS 0.027086f
C95 variable_delay_unit_0.tristate_inverter_1.en.t2 VSS 0.035f
C96 variable_delay_unit_0.tristate_inverter_1.en.t6 VSS 0.035f
C97 variable_delay_unit_0.tristate_inverter_1.en.n0 VSS 0.103163f
C98 variable_delay_unit_0.tristate_inverter_1.en.t1 VSS 0.215011f
C99 variable_delay_unit_0.tristate_inverter_1.en.t0 VSS 0.067642f
C100 variable_delay_unit_0.tristate_inverter_1.en.n1 VSS 0.85898f
C101 variable_delay_unit_0.tristate_inverter_1.en.n2 VSS 0.944443f
C102 variable_delay_unit_0.tristate_inverter_1.en.t5 VSS 0.093268f
C103 variable_delay_unit_0.tristate_inverter_1.en.t7 VSS 0.086397f
C104 variable_delay_unit_0.tristate_inverter_1.en.t3 VSS 0.093582f
C105 variable_delay_unit_0.tristate_inverter_1.en.n3 VSS 0.091588f
C106 variable_delay_unit_0.tristate_inverter_1.en.n4 VSS 0.06359f
C107 variable_delay_unit_1.forward.t2 VSS 0.067654f
C108 variable_delay_unit_1.forward.t3 VSS 0.025654f
C109 variable_delay_unit_1.forward.n0 VSS 0.071153f
C110 variable_delay_unit_1.forward.t0 VSS 0.04984f
C111 variable_delay_unit_1.forward.t1 VSS 0.15845f
C112 variable_delay_unit_1.forward.n1 VSS 0.384027f
C113 variable_delay_unit_1.forward.n2 VSS 0.632469f
C114 variable_delay_unit_1.tristate_inverter_1.en.t5 VSS 0.027086f
C115 variable_delay_unit_1.tristate_inverter_1.en.t2 VSS 0.035f
C116 variable_delay_unit_1.tristate_inverter_1.en.t3 VSS 0.035f
C117 variable_delay_unit_1.tristate_inverter_1.en.n0 VSS 0.103163f
C118 variable_delay_unit_1.tristate_inverter_1.en.t1 VSS 0.215011f
C119 variable_delay_unit_1.tristate_inverter_1.en.t0 VSS 0.067642f
C120 variable_delay_unit_1.tristate_inverter_1.en.n1 VSS 0.85898f
C121 variable_delay_unit_1.tristate_inverter_1.en.n2 VSS 0.944443f
C122 variable_delay_unit_1.tristate_inverter_1.en.t7 VSS 0.093268f
C123 variable_delay_unit_1.tristate_inverter_1.en.t4 VSS 0.086397f
C124 variable_delay_unit_1.tristate_inverter_1.en.t6 VSS 0.093582f
C125 variable_delay_unit_1.tristate_inverter_1.en.n3 VSS 0.091588f
C126 variable_delay_unit_1.tristate_inverter_1.en.n4 VSS 0.06359f
C127 VDD.n0 VSS 0.190382f
C128 VDD.t21 VSS 0.046888f
C129 VDD.n1 VSS 0.048588f
C130 VDD.n2 VSS 0.043398f
C131 VDD.n3 VSS 0.028635f
C132 VDD.t37 VSS 0.195867f
C133 VDD.n4 VSS 0.05654f
C134 VDD.n5 VSS 0.05654f
C135 VDD.t38 VSS 0.046888f
C136 VDD.n6 VSS 0.019547f
C137 VDD.n7 VSS 0.190382f
C138 VDD.n8 VSS 0.053221f
C139 VDD.t41 VSS 0.012494f
C140 VDD.t43 VSS 0.012494f
C141 VDD.n9 VSS 0.036465f
C142 VDD.t10 VSS 0.046131f
C143 VDD.n10 VSS 0.166326f
C144 VDD.n11 VSS 0.071912f
C145 VDD.n12 VSS 0.053221f
C146 VDD.n13 VSS 0.03368f
C147 VDD.n14 VSS 0.183676f
C148 VDD.t0 VSS 0.156929f
C149 VDD.n15 VSS 0.08687f
C150 VDD.n16 VSS 0.08687f
C151 VDD.t24 VSS 0.012494f
C152 VDD.t30 VSS 0.012494f
C153 VDD.n17 VSS 0.036465f
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
