13hihi31/tt09-analog-tdc/mag/variable_delay_short.sim.spice

* NGSPICE file created from variable_delay_short_parax.ext - technology: sky130A

.subckt variable_delay_short_parax in en_1 out en_2 en_3 en_0 en_4 VSS VDD
X0 a_16354_772# variable_delay_unit_5.tristate_inverter_1.en.t2 VDD.t86 VDD.t85 sky130_fd_pr__pfet_01v8 ad=0.435 pd=3.29 as=0.435 ps=3.29 w=3 l=0.15
X1 VDD.t54 en_1.t0 a_5444_772# VDD.t53 sky130_fd_pr__pfet_01v8 ad=0.87 pd=6.58 as=0.435 ps=3.29 w=3 l=0.15
X2 VSS.t71 variable_delay_unit_2.tristate_inverter_1.en.t2 a_8392_352# VSS.t70 sky130_fd_pr__nfet_01v8 ad=0.145 pd=1.29 as=0.145 ps=1.29 w=1 l=0.15
X3 variable_delay_unit_4.in.t1 variable_delay_unit_3.in.t2 VDD.t4 VDD.t3 sky130_fd_pr__pfet_01v8 ad=0.87 pd=6.58 as=0.87 ps=6.58 w=3 l=0.15
X4 a_16354_352# VDD.t112 VSS.t79 VSS.t78 sky130_fd_pr__nfet_01v8 ad=0.145 pd=1.29 as=0.145 ps=1.29 w=1 l=0.15
X5 VDD.t24 en_1.t1 a_5444_772# VDD.t23 sky130_fd_pr__pfet_01v8 ad=0.435 pd=3.29 as=0.435 ps=3.29 w=3 l=0.15
X6 variable_delay_unit_3.in.t1 variable_delay_unit_2.in.t2 VDD.t40 VDD.t39 sky130_fd_pr__pfet_01v8 ad=0.87 pd=6.58 as=0.87 ps=6.58 w=3 l=0.15
X7 VDD.t50 en_0.t0 a_2496_772# VDD.t49 sky130_fd_pr__pfet_01v8 ad=0.87 pd=6.58 as=0.435 ps=3.29 w=3 l=0.15
X8 VDD.t80 VDD.t78 a_17236_772# VDD.t79 sky130_fd_pr__pfet_01v8 ad=0.435 pd=3.29 as=0.435 ps=3.29 w=3 l=0.15
X9 variable_delay_unit_4.in.t0 variable_delay_unit_3.in.t3 VSS.t18 VSS.t17 sky130_fd_pr__nfet_01v8 ad=0.29 pd=2.58 as=0.29 ps=2.58 w=1 l=0.15
X10 VSS.t36 variable_delay_unit_1.tristate_inverter_1.en.t2 a_5444_352# VSS.t35 sky130_fd_pr__nfet_01v8 ad=0.29 pd=2.58 as=0.145 ps=1.29 w=1 l=0.15
X11 variable_delay_unit_3.in.t0 variable_delay_unit_2.in.t3 VSS.t1 VSS.t0 sky130_fd_pr__nfet_01v8 ad=0.29 pd=2.58 as=0.29 ps=2.58 w=1 l=0.15
X12 VSS.t48 variable_delay_unit_1.tristate_inverter_1.en.t3 a_5444_352# VSS.t47 sky130_fd_pr__nfet_01v8 ad=0.145 pd=1.29 as=0.145 ps=1.29 w=1 l=0.15
X13 VSS.t85 variable_delay_unit_5.tristate_inverter_1.en.t3 a_17236_352# VSS.t84 sky130_fd_pr__nfet_01v8 ad=0.145 pd=1.29 as=0.145 ps=1.29 w=1 l=0.15
X14 VDD.t94 variable_delay_unit_2.tristate_inverter_1.en.t3 a_7510_772# VDD.t93 sky130_fd_pr__pfet_01v8 ad=0.435 pd=3.29 as=0.435 ps=3.29 w=3 l=0.15
X15 VSS.t50 variable_delay_unit_0.tristate_inverter_1.en.t2 a_2496_352# VSS.t49 sky130_fd_pr__nfet_01v8 ad=0.29 pd=2.58 as=0.145 ps=1.29 w=1 l=0.15
X16 variable_delay_unit_1.out variable_delay_unit_2.in.t4 a_4562_772# VDD.t68 sky130_fd_pr__pfet_01v8 ad=0.87 pd=6.58 as=0.435 ps=3.29 w=3 l=0.15
X17 variable_delay_unit_5.forward.t1 variable_delay_unit_5.in.t2 VDD.t96 VDD.t95 sky130_fd_pr__pfet_01v8 ad=0.87 pd=6.58 as=0.87 ps=6.58 w=3 l=0.15
X18 VDD.t57 en_4.t0 a_14288_772# VDD.t56 sky130_fd_pr__pfet_01v8 ad=0.435 pd=3.29 as=0.435 ps=3.29 w=3 l=0.15
X19 VDD.t108 variable_delay_unit_1.tristate_inverter_1.en.t4 a_4562_772# VDD.t107 sky130_fd_pr__pfet_01v8 ad=0.435 pd=3.29 as=0.435 ps=3.29 w=3 l=0.15
X20 VDD.t52 en_3.t0 a_11340_772# VDD.t51 sky130_fd_pr__pfet_01v8 ad=0.87 pd=6.58 as=0.435 ps=3.29 w=3 l=0.15
X21 variable_delay_unit_0.tristate_inverter_1.en.t1 en_0.t1 VDD.t26 VDD.t25 sky130_fd_pr__pfet_01v8 ad=0.87 pd=6.58 as=0.87 ps=6.58 w=3 l=0.15
X22 VSS.t7 en_2.t0 a_7510_352# VSS.t6 sky130_fd_pr__nfet_01v8 ad=0.145 pd=1.29 as=0.145 ps=1.29 w=1 l=0.15
X23 variable_delay_unit_1.out variable_delay_unit_2.in.t5 a_4562_352# VSS.t8 sky130_fd_pr__nfet_01v8 ad=0.29 pd=2.58 as=0.145 ps=1.29 w=1 l=0.15
X24 out.t2 variable_delay_unit_1.in.t2 a_1614_772# VDD.t60 sky130_fd_pr__pfet_01v8 ad=0.87 pd=6.58 as=0.435 ps=3.29 w=3 l=0.15
X25 variable_delay_unit_5.forward.t0 variable_delay_unit_5.in.t3 VSS.t3 VSS.t2 sky130_fd_pr__nfet_01v8 ad=0.29 pd=2.58 as=0.29 ps=2.58 w=1 l=0.15
X26 VSS.t89 variable_delay_unit_4.tristate_inverter_1.en.t2 a_14288_352# VSS.t88 sky130_fd_pr__nfet_01v8 ad=0.145 pd=1.29 as=0.145 ps=1.29 w=1 l=0.15
X27 VSS.t30 en_1.t2 a_4562_352# VSS.t29 sky130_fd_pr__nfet_01v8 ad=0.145 pd=1.29 as=0.145 ps=1.29 w=1 l=0.15
X28 variable_delay_unit_0.tristate_inverter_1.en.t0 en_0.t2 VSS.t104 VSS.t103 sky130_fd_pr__nfet_01v8 ad=0.29 pd=2.58 as=0.29 ps=2.58 w=1 l=0.15
X29 VSS.t40 variable_delay_unit_3.tristate_inverter_1.en.t2 a_11340_352# VSS.t39 sky130_fd_pr__nfet_01v8 ad=0.29 pd=2.58 as=0.145 ps=1.29 w=1 l=0.15
X30 variable_delay_unit_5.in.t1 variable_delay_unit_4.in.t2 VDD.t110 VDD.t109 sky130_fd_pr__pfet_01v8 ad=0.87 pd=6.58 as=0.87 ps=6.58 w=3 l=0.15
X31 VDD.t18 variable_delay_unit_4.tristate_inverter_1.en.t3 a_13406_772# VDD.t17 sky130_fd_pr__pfet_01v8 ad=0.435 pd=3.29 as=0.435 ps=3.29 w=3 l=0.15
X32 variable_delay_unit_3.out variable_delay_unit_4.in.t3 a_10458_772# VDD.t111 sky130_fd_pr__pfet_01v8 ad=0.87 pd=6.58 as=0.435 ps=3.29 w=3 l=0.15
X33 out.t3 variable_delay_unit_1.in.t3 a_1614_352# VSS.t14 sky130_fd_pr__nfet_01v8 ad=0.29 pd=2.58 as=0.145 ps=1.29 w=1 l=0.15
X34 VDD.t20 en_2.t1 a_8392_772# VDD.t19 sky130_fd_pr__pfet_01v8 ad=0.87 pd=6.58 as=0.435 ps=3.29 w=3 l=0.15
X35 variable_delay_unit_5.in.t0 variable_delay_unit_4.in.t4 VSS.t32 VSS.t31 sky130_fd_pr__nfet_01v8 ad=0.29 pd=2.58 as=0.29 ps=2.58 w=1 l=0.15
X36 VSS.t53 en_4.t1 a_13406_352# VSS.t52 sky130_fd_pr__nfet_01v8 ad=0.145 pd=1.29 as=0.145 ps=1.29 w=1 l=0.15
X37 variable_delay_unit_3.out variable_delay_unit_4.in.t5 a_10458_352# VSS.t102 sky130_fd_pr__nfet_01v8 ad=0.29 pd=2.58 as=0.145 ps=1.29 w=1 l=0.15
X38 a_2496_772# variable_delay_unit_1.out out.t1 VDD.t67 sky130_fd_pr__pfet_01v8 ad=0.435 pd=3.29 as=0.87 ps=6.58 w=3 l=0.15
X39 VDD.t77 VDD.t75 a_17236_772# VDD.t76 sky130_fd_pr__pfet_01v8 ad=0.87 pd=6.58 as=0.435 ps=3.29 w=3 l=0.15
X40 VDD.t66 variable_delay_unit_3.tristate_inverter_1.en.t3 a_10458_772# VDD.t65 sky130_fd_pr__pfet_01v8 ad=0.435 pd=3.29 as=0.435 ps=3.29 w=3 l=0.15
X41 VSS.t69 variable_delay_unit_2.tristate_inverter_1.en.t4 a_8392_352# VSS.t68 sky130_fd_pr__nfet_01v8 ad=0.29 pd=2.58 as=0.145 ps=1.29 w=1 l=0.15
X42 VSS.t83 variable_delay_unit_5.tristate_inverter_1.en.t4 a_17236_352# VSS.t82 sky130_fd_pr__nfet_01v8 ad=0.29 pd=2.58 as=0.145 ps=1.29 w=1 l=0.15
X43 variable_delay_unit_2.out variable_delay_unit_3.in.t4 a_7510_772# VDD.t0 sky130_fd_pr__pfet_01v8 ad=0.87 pd=6.58 as=0.435 ps=3.29 w=3 l=0.15
X44 a_2496_352# variable_delay_unit_1.out out.t0 VSS.t60 sky130_fd_pr__nfet_01v8 ad=0.145 pd=1.29 as=0.29 ps=2.58 w=1 l=0.15
X45 VSS.t55 en_3.t1 a_10458_352# VSS.t54 sky130_fd_pr__nfet_01v8 ad=0.145 pd=1.29 as=0.145 ps=1.29 w=1 l=0.15
X46 VDD.t30 en_4.t2 a_14288_772# VDD.t29 sky130_fd_pr__pfet_01v8 ad=0.87 pd=6.58 as=0.435 ps=3.29 w=3 l=0.15
X47 a_1614_772# variable_delay_unit_0.tristate_inverter_1.en.t3 VDD.t6 VDD.t5 sky130_fd_pr__pfet_01v8 ad=0.435 pd=3.29 as=0.87 ps=6.58 w=3 l=0.15
X48 variable_delay_unit_2.out variable_delay_unit_3.in.t5 a_7510_352# VSS.t61 sky130_fd_pr__nfet_01v8 ad=0.29 pd=2.58 as=0.145 ps=1.29 w=1 l=0.15
X49 VSS.t99 variable_delay_unit_4.tristate_inverter_1.en.t4 a_14288_352# VSS.t98 sky130_fd_pr__nfet_01v8 ad=0.29 pd=2.58 as=0.145 ps=1.29 w=1 l=0.15
X50 a_1614_352# en_0.t3 VSS.t10 VSS.t9 sky130_fd_pr__nfet_01v8 ad=0.145 pd=1.29 as=0.29 ps=2.58 w=1 l=0.15
X51 variable_delay_unit_5.out variable_delay_unit_5.forward.t2 a_16354_772# VDD.t31 sky130_fd_pr__pfet_01v8 ad=0.87 pd=6.58 as=0.435 ps=3.29 w=3 l=0.15
X52 a_5444_772# en_1.t3 VDD.t14 VDD.t13 sky130_fd_pr__pfet_01v8 ad=0.435 pd=3.29 as=0.435 ps=3.29 w=3 l=0.15
X53 a_8392_772# variable_delay_unit_3.out variable_delay_unit_2.out VDD.t104 sky130_fd_pr__pfet_01v8 ad=0.435 pd=3.29 as=0.87 ps=6.58 w=3 l=0.15
X54 VDD.t84 variable_delay_unit_5.tristate_inverter_1.en.t5 a_16354_772# VDD.t83 sky130_fd_pr__pfet_01v8 ad=0.435 pd=3.29 as=0.435 ps=3.29 w=3 l=0.15
X55 variable_delay_unit_4.out variable_delay_unit_5.in.t4 a_13406_772# VDD.t55 sky130_fd_pr__pfet_01v8 ad=0.87 pd=6.58 as=0.435 ps=3.29 w=3 l=0.15
X56 variable_delay_unit_1.tristate_inverter_1.en.t1 en_1.t4 VDD.t12 VDD.t11 sky130_fd_pr__pfet_01v8 ad=0.87 pd=6.58 as=0.87 ps=6.58 w=3 l=0.15
X57 variable_delay_unit_5.out variable_delay_unit_5.forward.t3 a_16354_352# VSS.t51 sky130_fd_pr__nfet_01v8 ad=0.29 pd=2.58 as=0.145 ps=1.29 w=1 l=0.15
X58 a_8392_352# variable_delay_unit_3.out variable_delay_unit_2.out VSS.t95 sky130_fd_pr__nfet_01v8 ad=0.145 pd=1.29 as=0.29 ps=2.58 w=1 l=0.15
X59 VSS.t77 VDD.t113 a_16354_352# VSS.t76 sky130_fd_pr__nfet_01v8 ad=0.145 pd=1.29 as=0.145 ps=1.29 w=1 l=0.15
X60 a_5444_352# variable_delay_unit_1.tristate_inverter_1.en.t5 VSS.t46 VSS.t45 sky130_fd_pr__nfet_01v8 ad=0.145 pd=1.29 as=0.145 ps=1.29 w=1 l=0.15
X61 variable_delay_unit_4.out variable_delay_unit_5.in.t5 a_13406_352# VSS.t13 sky130_fd_pr__nfet_01v8 ad=0.29 pd=2.58 as=0.145 ps=1.29 w=1 l=0.15
X62 a_5444_772# variable_delay_unit_2.out variable_delay_unit_1.out VDD.t106 sky130_fd_pr__pfet_01v8 ad=0.435 pd=3.29 as=0.87 ps=6.58 w=3 l=0.15
X63 variable_delay_unit_1.tristate_inverter_1.en.t0 en_1.t5 VSS.t26 VSS.t25 sky130_fd_pr__nfet_01v8 ad=0.29 pd=2.58 as=0.29 ps=2.58 w=1 l=0.15
X64 a_2496_772# en_0.t4 VDD.t28 VDD.t27 sky130_fd_pr__pfet_01v8 ad=0.435 pd=3.29 as=0.435 ps=3.29 w=3 l=0.15
X65 a_7510_772# variable_delay_unit_2.tristate_inverter_1.en.t5 VDD.t92 VDD.t91 sky130_fd_pr__pfet_01v8 ad=0.435 pd=3.29 as=0.87 ps=6.58 w=3 l=0.15
X66 a_5444_352# variable_delay_unit_2.out variable_delay_unit_1.out VSS.t101 sky130_fd_pr__nfet_01v8 ad=0.145 pd=1.29 as=0.29 ps=2.58 w=1 l=0.15
X67 a_2496_352# variable_delay_unit_0.tristate_inverter_1.en.t4 VSS.t63 VSS.t62 sky130_fd_pr__nfet_01v8 ad=0.145 pd=1.29 as=0.145 ps=1.29 w=1 l=0.15
X68 a_7510_352# en_2.t2 VSS.t5 VSS.t4 sky130_fd_pr__nfet_01v8 ad=0.145 pd=1.29 as=0.29 ps=2.58 w=1 l=0.15
X69 a_4562_772# variable_delay_unit_1.tristate_inverter_1.en.t6 VDD.t46 VDD.t45 sky130_fd_pr__pfet_01v8 ad=0.435 pd=3.29 as=0.87 ps=6.58 w=3 l=0.15
X70 a_14288_772# variable_delay_unit_5.out variable_delay_unit_4.out VDD.t103 sky130_fd_pr__pfet_01v8 ad=0.435 pd=3.29 as=0.87 ps=6.58 w=3 l=0.15
X71 a_11340_772# en_3.t2 VDD.t10 VDD.t9 sky130_fd_pr__pfet_01v8 ad=0.435 pd=3.29 as=0.435 ps=3.29 w=3 l=0.15
X72 a_1614_772# variable_delay_unit_0.tristate_inverter_1.en.t5 VDD.t100 VDD.t99 sky130_fd_pr__pfet_01v8 ad=0.435 pd=3.29 as=0.435 ps=3.29 w=3 l=0.15
X73 variable_delay_unit_3.tristate_inverter_1.en.t1 en_3.t3 VDD.t59 VDD.t58 sky130_fd_pr__pfet_01v8 ad=0.87 pd=6.58 as=0.87 ps=6.58 w=3 l=0.15
X74 a_11340_772# variable_delay_unit_4.out variable_delay_unit_3.out VDD.t105 sky130_fd_pr__pfet_01v8 ad=0.435 pd=3.29 as=0.87 ps=6.58 w=3 l=0.15
X75 a_14288_352# variable_delay_unit_5.out variable_delay_unit_4.out VSS.t92 sky130_fd_pr__nfet_01v8 ad=0.145 pd=1.29 as=0.29 ps=2.58 w=1 l=0.15
X76 a_4562_352# en_1.t6 VSS.t28 VSS.t27 sky130_fd_pr__nfet_01v8 ad=0.145 pd=1.29 as=0.29 ps=2.58 w=1 l=0.15
X77 a_11340_352# variable_delay_unit_3.tristate_inverter_1.en.t4 VSS.t59 VSS.t58 sky130_fd_pr__nfet_01v8 ad=0.145 pd=1.29 as=0.145 ps=1.29 w=1 l=0.15
X78 variable_delay_unit_3.tristate_inverter_1.en.t0 en_3.t4 VSS.t44 VSS.t43 sky130_fd_pr__nfet_01v8 ad=0.29 pd=2.58 as=0.29 ps=2.58 w=1 l=0.15
X79 a_1614_352# en_0.t5 VSS.t108 VSS.t107 sky130_fd_pr__nfet_01v8 ad=0.145 pd=1.29 as=0.145 ps=1.29 w=1 l=0.15
X80 variable_delay_unit_1.in.t0 in.t0 VDD.t90 VDD.t89 sky130_fd_pr__pfet_01v8 ad=0.87 pd=6.58 as=0.87 ps=6.58 w=3 l=0.15
X81 a_11340_352# variable_delay_unit_4.out variable_delay_unit_3.out VSS.t100 sky130_fd_pr__nfet_01v8 ad=0.145 pd=1.29 as=0.29 ps=2.58 w=1 l=0.15
X82 a_13406_772# variable_delay_unit_4.tristate_inverter_1.en.t5 VDD.t8 VDD.t7 sky130_fd_pr__pfet_01v8 ad=0.435 pd=3.29 as=0.87 ps=6.58 w=3 l=0.15
X83 variable_delay_unit_2.tristate_inverter_1.en.t0 en_2.t3 VDD.t33 VDD.t32 sky130_fd_pr__pfet_01v8 ad=0.87 pd=6.58 as=0.87 ps=6.58 w=3 l=0.15
X84 a_8392_772# en_2.t4 VDD.t42 VDD.t41 sky130_fd_pr__pfet_01v8 ad=0.435 pd=3.29 as=0.435 ps=3.29 w=3 l=0.15
X85 variable_delay_unit_1.in.t1 in.t1 VSS.t106 VSS.t105 sky130_fd_pr__nfet_01v8 ad=0.29 pd=2.58 as=0.29 ps=2.58 w=1 l=0.15
X86 a_13406_352# en_4.t3 VSS.t20 VSS.t19 sky130_fd_pr__nfet_01v8 ad=0.145 pd=1.29 as=0.29 ps=2.58 w=1 l=0.15
X87 variable_delay_unit_2.tristate_inverter_1.en.t1 en_2.t5 VSS.t87 VSS.t86 sky130_fd_pr__nfet_01v8 ad=0.29 pd=2.58 as=0.29 ps=2.58 w=1 l=0.15
X88 a_17236_772# VDD.t72 VDD.t74 VDD.t73 sky130_fd_pr__pfet_01v8 ad=0.435 pd=3.29 as=0.435 ps=3.29 w=3 l=0.15
X89 a_8392_352# variable_delay_unit_2.tristate_inverter_1.en.t6 VSS.t67 VSS.t66 sky130_fd_pr__nfet_01v8 ad=0.145 pd=1.29 as=0.145 ps=1.29 w=1 l=0.15
X90 a_10458_772# variable_delay_unit_3.tristate_inverter_1.en.t5 VDD.t98 VDD.t97 sky130_fd_pr__pfet_01v8 ad=0.435 pd=3.29 as=0.87 ps=6.58 w=3 l=0.15
X91 variable_delay_unit_5.tristate_inverter_1.en.t1 VDD.t69 VDD.t71 VDD.t70 sky130_fd_pr__pfet_01v8 ad=0.87 pd=6.58 as=0.87 ps=6.58 w=3 l=0.15
X92 a_17236_352# variable_delay_unit_5.tristate_inverter_1.en.t6 VSS.t81 VSS.t80 sky130_fd_pr__nfet_01v8 ad=0.145 pd=1.29 as=0.145 ps=1.29 w=1 l=0.15
X93 a_7510_772# variable_delay_unit_2.tristate_inverter_1.en.t7 VDD.t38 VDD.t37 sky130_fd_pr__pfet_01v8 ad=0.435 pd=3.29 as=0.435 ps=3.29 w=3 l=0.15
X94 a_10458_352# en_3.t5 VSS.t42 VSS.t41 sky130_fd_pr__nfet_01v8 ad=0.145 pd=1.29 as=0.29 ps=2.58 w=1 l=0.15
X95 variable_delay_unit_5.tristate_inverter_1.en.t0 VDD.t114 VSS.t75 VSS.t74 sky130_fd_pr__nfet_01v8 ad=0.29 pd=2.58 as=0.29 ps=2.58 w=1 l=0.15
X96 a_17236_772# VSS.t109 variable_delay_unit_5.out VDD.t36 sky130_fd_pr__pfet_01v8 ad=0.435 pd=3.29 as=0.87 ps=6.58 w=3 l=0.15
X97 a_14288_772# en_4.t4 VDD.t44 VDD.t43 sky130_fd_pr__pfet_01v8 ad=0.435 pd=3.29 as=0.435 ps=3.29 w=3 l=0.15
X98 a_7510_352# en_2.t6 VSS.t22 VSS.t21 sky130_fd_pr__nfet_01v8 ad=0.145 pd=1.29 as=0.145 ps=1.29 w=1 l=0.15
X99 variable_delay_unit_4.tristate_inverter_1.en.t1 en_4.t5 VDD.t2 VDD.t1 sky130_fd_pr__pfet_01v8 ad=0.87 pd=6.58 as=0.87 ps=6.58 w=3 l=0.15
X100 a_4562_772# variable_delay_unit_1.tristate_inverter_1.en.t7 VDD.t22 VDD.t21 sky130_fd_pr__pfet_01v8 ad=0.435 pd=3.29 as=0.435 ps=3.29 w=3 l=0.15
X101 a_17236_352# VSS.t15 variable_delay_unit_5.out VSS.t16 sky130_fd_pr__nfet_01v8 ad=0.145 pd=1.29 as=0.29 ps=2.58 w=1 l=0.15
X102 a_14288_352# variable_delay_unit_4.tristate_inverter_1.en.t6 VSS.t57 VSS.t56 sky130_fd_pr__nfet_01v8 ad=0.145 pd=1.29 as=0.145 ps=1.29 w=1 l=0.15
X103 variable_delay_unit_4.tristate_inverter_1.en.t0 en_4.t6 VSS.t65 VSS.t64 sky130_fd_pr__nfet_01v8 ad=0.29 pd=2.58 as=0.29 ps=2.58 w=1 l=0.15
X104 a_16354_772# variable_delay_unit_5.tristate_inverter_1.en.t7 VDD.t82 VDD.t81 sky130_fd_pr__pfet_01v8 ad=0.435 pd=3.29 as=0.87 ps=6.58 w=3 l=0.15
X105 a_13406_772# variable_delay_unit_4.tristate_inverter_1.en.t7 VDD.t62 VDD.t61 sky130_fd_pr__pfet_01v8 ad=0.435 pd=3.29 as=0.435 ps=3.29 w=3 l=0.15
X106 a_4562_352# en_1.t7 VSS.t24 VSS.t23 sky130_fd_pr__nfet_01v8 ad=0.145 pd=1.29 as=0.145 ps=1.29 w=1 l=0.15
X107 a_16354_352# VDD.t115 VSS.t73 VSS.t72 sky130_fd_pr__nfet_01v8 ad=0.145 pd=1.29 as=0.29 ps=2.58 w=1 l=0.15
X108 a_13406_352# en_4.t7 VSS.t12 VSS.t11 sky130_fd_pr__nfet_01v8 ad=0.145 pd=1.29 as=0.145 ps=1.29 w=1 l=0.15
X109 VDD.t35 en_0.t6 a_2496_772# VDD.t34 sky130_fd_pr__pfet_01v8 ad=0.435 pd=3.29 as=0.435 ps=3.29 w=3 l=0.15
X110 variable_delay_unit_2.in.t0 variable_delay_unit_1.in.t4 VDD.t102 VDD.t101 sky130_fd_pr__pfet_01v8 ad=0.87 pd=6.58 as=0.87 ps=6.58 w=3 l=0.15
X111 a_10458_772# variable_delay_unit_3.tristate_inverter_1.en.t6 VDD.t64 VDD.t63 sky130_fd_pr__pfet_01v8 ad=0.435 pd=3.29 as=0.435 ps=3.29 w=3 l=0.15
X112 variable_delay_unit_2.in.t1 variable_delay_unit_1.in.t5 VSS.t94 VSS.t93 sky130_fd_pr__nfet_01v8 ad=0.29 pd=2.58 as=0.29 ps=2.58 w=1 l=0.15
X113 VSS.t97 variable_delay_unit_0.tristate_inverter_1.en.t6 a_2496_352# VSS.t96 sky130_fd_pr__nfet_01v8 ad=0.145 pd=1.29 as=0.145 ps=1.29 w=1 l=0.15
X114 a_10458_352# en_3.t6 VSS.t38 VSS.t37 sky130_fd_pr__nfet_01v8 ad=0.145 pd=1.29 as=0.145 ps=1.29 w=1 l=0.15
X115 VDD.t48 variable_delay_unit_0.tristate_inverter_1.en.t7 a_1614_772# VDD.t47 sky130_fd_pr__pfet_01v8 ad=0.435 pd=3.29 as=0.435 ps=3.29 w=3 l=0.15
X116 VDD.t16 en_3.t7 a_11340_772# VDD.t15 sky130_fd_pr__pfet_01v8 ad=0.435 pd=3.29 as=0.435 ps=3.29 w=3 l=0.15
X117 VSS.t34 en_0.t7 a_1614_352# VSS.t33 sky130_fd_pr__nfet_01v8 ad=0.145 pd=1.29 as=0.145 ps=1.29 w=1 l=0.15
X118 VSS.t91 variable_delay_unit_3.tristate_inverter_1.en.t7 a_11340_352# VSS.t90 sky130_fd_pr__nfet_01v8 ad=0.145 pd=1.29 as=0.145 ps=1.29 w=1 l=0.15
X119 VDD.t88 en_2.t7 a_8392_772# VDD.t87 sky130_fd_pr__pfet_01v8 ad=0.435 pd=3.29 as=0.435 ps=3.29 w=3 l=0.15
R0 variable_delay_unit_5.tristate_inverter_1.en.n3 variable_delay_unit_5.tristate_inverter_1.en.t7 628.097
R1 variable_delay_unit_5.tristate_inverter_1.en.n4 variable_delay_unit_5.tristate_inverter_1.en.t2 622.766
R2 variable_delay_unit_5.tristate_inverter_1.en.n3 variable_delay_unit_5.tristate_inverter_1.en.t5 523.774
R3 variable_delay_unit_5.tristate_inverter_1.en.n0 variable_delay_unit_5.tristate_inverter_1.en.t3 304.647
R4 variable_delay_unit_5.tristate_inverter_1.en.n0 variable_delay_unit_5.tristate_inverter_1.en.t4 304.647
R5 variable_delay_unit_5.tristate_inverter_1.en.n0 variable_delay_unit_5.tristate_inverter_1.en.t6 202.44
R6 variable_delay_unit_5.tristate_inverter_1.en variable_delay_unit_5.tristate_inverter_1.en.n0 168.969
R7 variable_delay_unit_5.tristate_inverter_1.en variable_delay_unit_5.tristate_inverter_1.en.n4 166.147
R8 variable_delay_unit_5.tristate_inverter_1.en.n1 variable_delay_unit_5.tristate_inverter_1.en.t1 84.7557
R9 variable_delay_unit_5.tristate_inverter_1.en.n1 variable_delay_unit_5.tristate_inverter_1.en.t0 84.1197
R10 variable_delay_unit_5.tristate_inverter_1.en.n2 variable_delay_unit_5.tristate_inverter_1.en.n1 12.6535
R11 variable_delay_unit_5.tristate_inverter_1.en.n2 variable_delay_unit_5.tristate_inverter_1.en 5.58443
R12 variable_delay_unit_5.tristate_inverter_1.en variable_delay_unit_5.tristate_inverter_1.en.n2 4.59003
R13 variable_delay_unit_5.tristate_inverter_1.en.n4 variable_delay_unit_5.tristate_inverter_1.en.n3 1.09595
R14 VDD.n298 VDD.n264 1689.71
R15 VDD.n269 VDD.n264 1689.71
R16 VDD.n262 VDD.n261 1689.71
R17 VDD.n301 VDD.n261 1689.71
R18 VDD.n238 VDD.n13 1689.71
R19 VDD.n238 VDD.n14 1689.71
R20 VDD.n20 VDD.n15 1689.71
R21 VDD.n234 VDD.n15 1689.71
R22 VDD.n210 VDD.n35 1689.71
R23 VDD.n210 VDD.n36 1689.71
R24 VDD.n42 VDD.n37 1689.71
R25 VDD.n206 VDD.n37 1689.71
R26 VDD.n182 VDD.n57 1689.71
R27 VDD.n182 VDD.n58 1689.71
R28 VDD.n64 VDD.n59 1689.71
R29 VDD.n178 VDD.n59 1689.71
R30 VDD.n154 VDD.n79 1689.71
R31 VDD.n154 VDD.n80 1689.71
R32 VDD.n86 VDD.n81 1689.71
R33 VDD.n150 VDD.n81 1689.71
R34 VDD.n118 VDD.n101 1689.71
R35 VDD.n118 VDD.n102 1689.71
R36 VDD.n108 VDD.n103 1689.71
R37 VDD.n114 VDD.n103 1689.71
R38 VDD.n132 VDD.n91 1307.92
R39 VDD.n128 VDD.n92 1307.92
R40 VDD.n168 VDD.n69 1307.92
R41 VDD.n164 VDD.n70 1307.92
R42 VDD.n196 VDD.n47 1307.92
R43 VDD.n192 VDD.n48 1307.92
R44 VDD.n224 VDD.n25 1307.92
R45 VDD.n220 VDD.n26 1307.92
R46 VDD.n252 VDD.n3 1307.92
R47 VDD.n248 VDD.n4 1307.92
R48 VDD.n281 VDD.n277 1307.92
R49 VDD.n274 VDD.n273 1307.92
R50 VDD.n138 VDD.t75 628.097
R51 VDD.n139 VDD.t78 622.766
R52 VDD.n142 VDD.t69 543.053
R53 VDD.n138 VDD.t72 523.774
R54 VDD.n300 VDD.n299 332.803
R55 VDD.n236 VDD.n235 332.803
R56 VDD.n208 VDD.n207 332.803
R57 VDD.n180 VDD.n179 332.803
R58 VDD.n152 VDD.n151 332.803
R59 VDD.n116 VDD.n115 332.803
R60 VDD.n137 VDD.t115 304.647
R61 VDD.n137 VDD.t112 304.647
R62 VDD.n142 VDD.t114 221.72
R63 VDD.n143 VDD.n142 219.526
R64 VDD.n137 VDD.t113 202.44
R65 VDD.n297 VDD.n265 180.236
R66 VDD.n270 VDD.n265 180.236
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
R410 VDD.n144 VDD.n143 2.2505
R411 VDD.n127 VDD.n126 2.04321
R412 VDD.n136 VDD.n88 2.04321
R413 VDD.n90 VDD.n89 2.04321
R414 VDD.n123 VDD.n95 2.04321
R415 VDD.n163 VDD.n162 2.04321
R416 VDD.n172 VDD.n66 2.04321
R417 VDD.n68 VDD.n67 2.04321
R418 VDD.n159 VDD.n73 2.04321
R419 VDD.n191 VDD.n190 2.04321
R420 VDD.n200 VDD.n44 2.04321
R421 VDD.n46 VDD.n45 2.04321
R422 VDD.n187 VDD.n51 2.04321
R423 VDD.n219 VDD.n218 2.04321
R424 VDD.n228 VDD.n22 2.04321
R425 VDD.n24 VDD.n23 2.04321
R426 VDD.n215 VDD.n29 2.04321
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
