13hihi31/tt09-analog-tdc/(commit log)

2024-10-04 Add xschem to project
    [pad_model.sch]
2024-10-10 Add inverter layout and schematic
    [inverter.sch, inverter_tb.sch]
2024-10-26 Add TDC schematic
    [delay_unit.sch, diff_gen.sch, diff_gen_tb.sch, inverter_file_tb.sch, phase_eq.sch, saff.sch, saff_tb.sch, tdc.sch]
2024-11-02 Add SAFF layout
    [delay_unit_laydriv.sch, diff_gen.sch, diff_gen_tb.sch, saff_2.sch, saff_bottom_latch.sch, saff_tb_post_layout.sch, sense_amplifier.sch, tdc_post_layout.sch]
2024-11-03 Add vernier delay line layout
    [delay_unit_laydriv.sch, saff_2_tb_post_layout.sch, tdc_vernier_delay_line_post_layout.sch, tdc_vernier_delay_line_tb.sch, vernier_delay_line.sch]
2024-11-04 Add stop_buffer layout
    [stop_buffer.sch, tdc_vernier_delay_line_diff_gen_tb.sch, tdc_vernier_delay_line_post_layout.sch]
2024-11-05 Add TDC layout
    [start_buffer.sch]
2024-11-09 Add variable delay layout
    [inverter_2.sch, tdc_vernier_buffers.sch, tdc_vernier_buffers_tb.sch, tdc_vernier_delay_line_post_layout.sch, tristate_inverter.sch, tristate_inverter_tb.sch, variable_delay.sch, variable_delay_tb.sch]
2024-11-10 Add fine delay layout
    [fine_delay.sch, fine_delay_parax_tb.sch, fine_delay_tb.sch, nand_gate.sch, nand_gate_tb.sch, tdc_vernier_buffers_tb.sch, test_signals_tb.sch, variable_delay_fine_delay_tb.sch]
2024-11-10 Add nand gate layout
    [nand_gate_tb.sch]
2024-11-10 Change variable delay length
    [input_stage.sch, input_stage_tb.sch, test_all.sch, variable_delay_dummy.sch, variable_delay_short.sch]
2024-11-10 Wire top cell
2024-11-10 Add long wire
2024-11-10 Wire first output
2024-11-10 Add TDC output wires
2024-11-10 Add all output wires
2024-11-10 Wire input_stage control
2024-11-10 Add variable delay control wires
2024-11-10 Wire start input_stage control
2024-11-10 Wire first input_stage to power
2024-11-10 Connect TDC to power
2024-11-10 Connect unsed pins to GND
2024-11-10 Add extra GND connection
2024-11-18 Add circuit diagrams
2025-09-14 Add top circuit symbol
    [input_stage_andpwr.sch, input_stage_andpwr_tb.sch, pad_model_ramp_tb.sch, test_tt_um_13hihi31_tdc.sch, test_tt_um_13hihi31_tdc_andpwr.sch, test_tt_um_13hihi31_tdc_parax.sch, tt_um_13hihi31_tdc.sch, tt_um_13hihi31_tdc_andpwr.sch]
2025-09-14 Use analog input to drive AND gate power
2025-09-14 Update GDS and LEF
    [input_stage_andpwr_parax_tb.sch, test_tt_um_13hihi31_tdc_andpwr_parax.sch, tt_um_13hihi31_tdc_andpwr.sch]
2026-09-10 Add test schematic diagram and tools cheat sheet
